devcexx/STeMCell/stemcell.kicad_pcb

## KiCad design stemcell.kicad_pcb (2025-03-15)

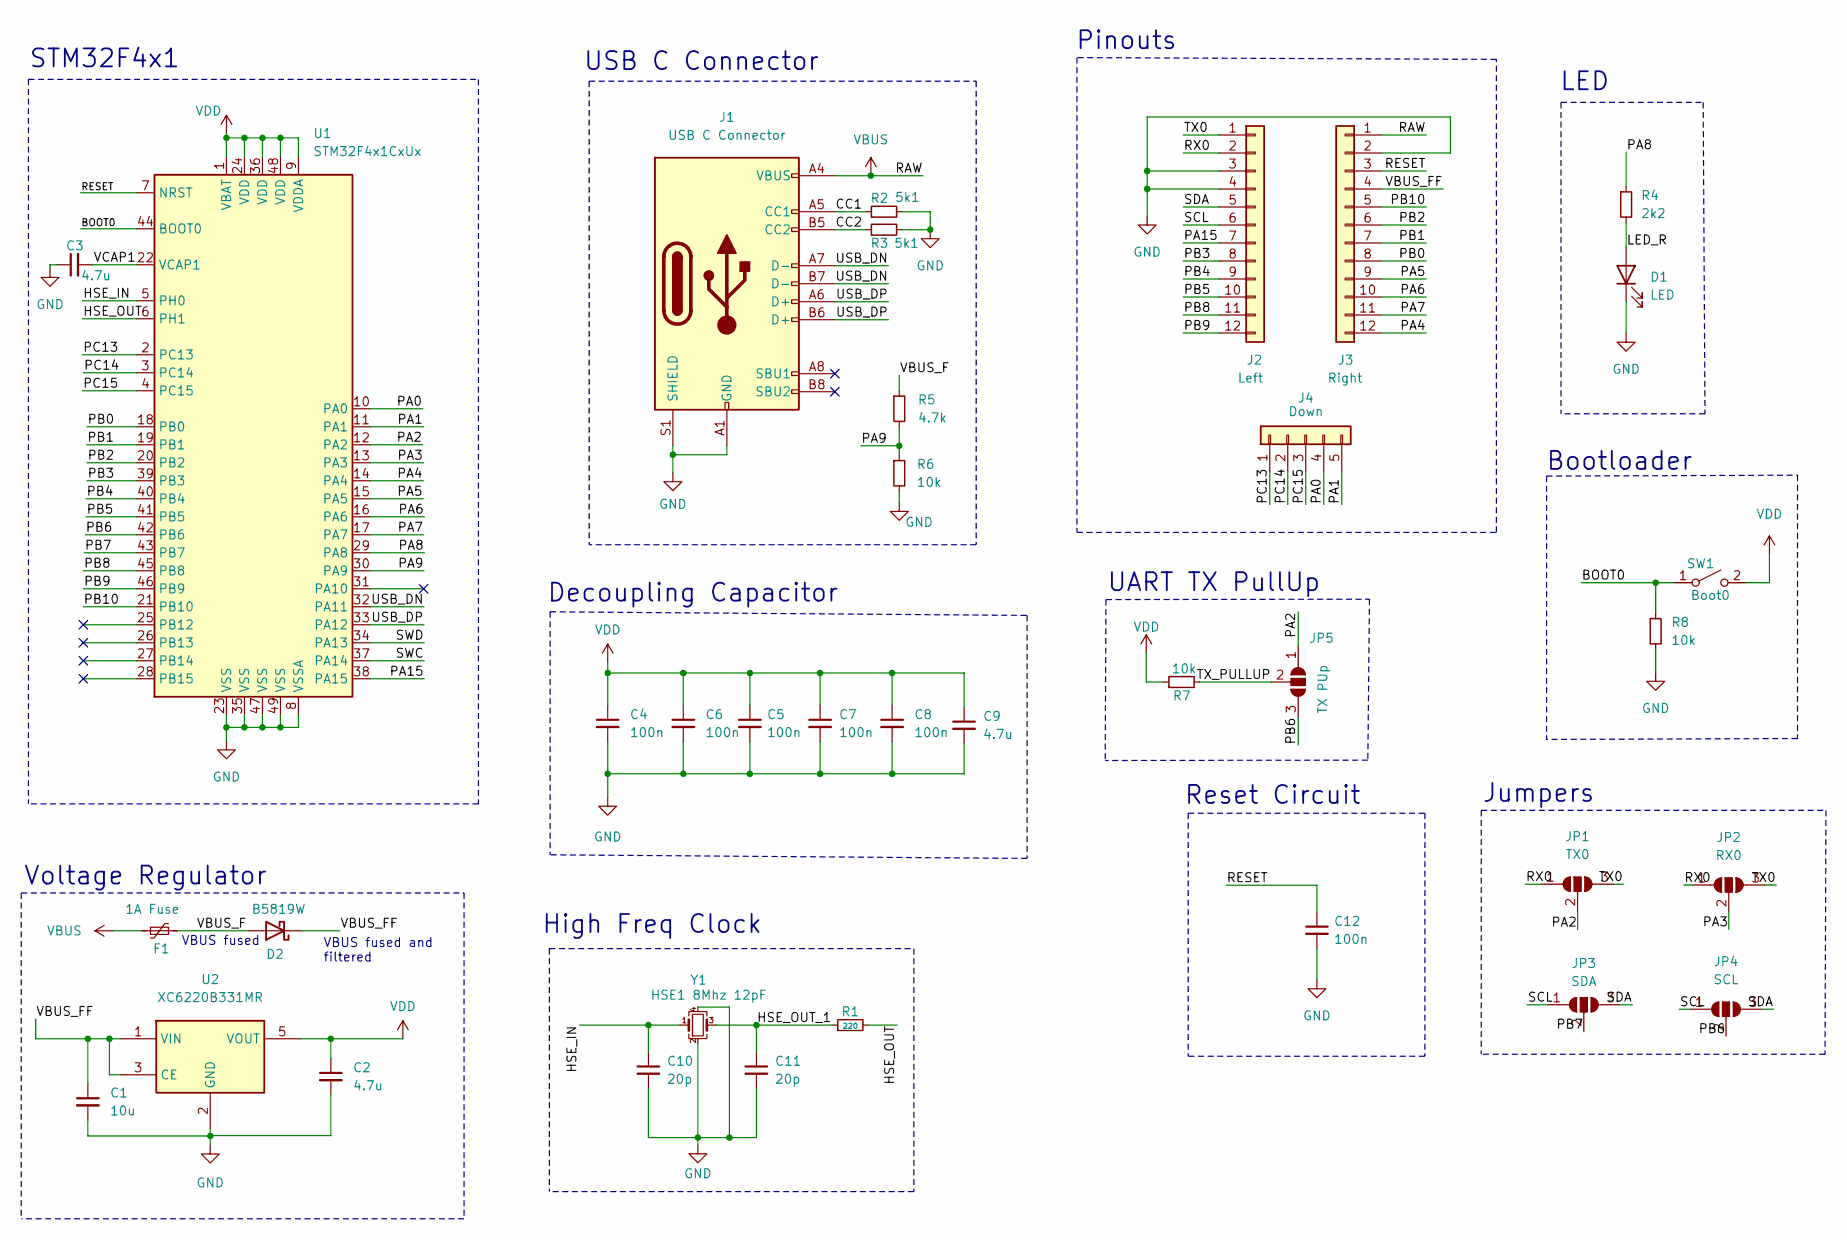
[picture p1: schematic stemcell.kicad_sch]

Parts:
C1: 10u; C_0402_1005Metric; LCSC C15525
C2, C3, C9: 4.7u; C_0402_1005Metric; LCSC C23733
C4, C5, C6, C7, C8, C12: 100n; C_0402_1005Metric; LCSC C1525
C10, C11: 20p; C_0402_1005Metric; LCSC C1554
D1: LED; LED_0402_1005Metric; LCSC C130724
D2: B5819W; D_SOD-123; LCSC C8598
F1: 1A Fuse; Fuse_0805_2012Metric; LCSC C135329
J1: USB C Connector; USB-C-SMD_MC-109-C10; LCSC C2874573
J2: Left; Pins12_castellated
J3: Right; Pins12_castellated
J4: Down; Pins5_castellated
JP1: TX0; SOLDER_JUMPER_3
JP2: RX0; SOLDER_JUMPER_3
JP3: SDA; SOLDER_JUMPER_3
JP4: SCL; SOLDER_JUMPER_3
JP5: TX PUp; SOLDER_JUMPER_3
R1: 220; R_0402_1005Metric; LCSC C25091
R2, R3: 5k1; R_0402_1005Metric; LCSC C25905
R4: 2k2; R_0402_1005Metric; LCSC C25879
R5: 4.7k; R_0402_1005Metric; LCSC C25900
R6, R7, R8: 10k; R_0402_1005Metric; LCSC C25744
SW1: Boot0; SW_SPST_CK_KXT3; LCSC C319433
U1: STM32F4x1CxUx; QFN-48-1EP_7x7mm_P0.5mm_EP5.6x5.6mm; LCSC C60420
U2: XC6220B331MR; SOT-23-5; LCSC C86534
Y1: HSE1 8Mhz 12pF; Crystal_SMD_3225-4Pin_3.2x2.5mm; LCSC C2682775

Connections:
/BOOT0: R8.1, SW1.1 (A), U1.44 (BOOT0)
/CC1: J1.A5 (CC1), R2.1
/CC2: J1.B5 (CC2), R3.1
/HSE_IN: C10.1, U1.5 (PH0), Y1.1
/HSE_OUT: R1.2, U1.6 (PH1)
/HSE_OUT_1: C11.1, R1.1, Y1.3
/LED_R: D1.2 (A), R4.2
/PA0: J4.4, U1.10 (PA0)
/PA1: J4.5, U1.11 (PA1)
/PA2: JP1.2 (C), JP5.1 (A), U1.12 (PA2)
/PA3: JP2.2 (C), U1.13 (PA3)
/PA4: J3.12, U1.14 (PA4)
/PA5: J3.9, U1.15 (PA5)
/PA6: J3.10, U1.16 (PA6)
/PA7: J3.11, U1.17 (PA7)
/PA8: R4.1, U1.29 (PA8)
/PA9: R5.2, R6.1, U1.30 (PA9)
/PA15: J2.7, U1.38 (PA15)
/PB0: J3.8, U1.18 (PB0)
/PB1: J3.7, U1.19 (PB1)
/PB2: J3.6, U1.20 (PB2)
/PB3: J2.8, U1.39 (PB3)
/PB4: J2.9, U1.40 (PB4)
/PB5: J2.10, U1.41 (PB5)
/PB6: JP4.2 (C), JP5.3 (B), U1.42 (PB6)
/PB7: JP3.2 (C), U1.43 (PB7)
/PB8: J2.11, U1.45 (PB8)
/PB9: J2.12, U1.46 (PB9)
/PB10: J3.5, U1.21 (PB10)
/PC13: J4.1, U1.2 (PC13)
/PC14: J4.2, U1.3 (PC14)
/PC15: J4.3, U1.4 (PC15)
/RESET: C12.1, J3.3, U1.7 (NRST)
/RX0: J2.2, JP1.1 (A), JP2.1 (A)
/SCL: J2.6, JP3.1 (A), JP4.1 (A)
/SDA: J2.5, JP3.3 (B), JP4.3 (B)
/SWC: U1.37 (PA14)
/SWD: U1.34 (PA13)
/TX0: J2.1, JP1.3 (B), JP2.3 (B)
/TX_PULLUP: JP5.2 (C), R7.2
/USB_DN: J1.A7 (D-), J1.B7 (D-), U1.32 (PA11)
/USB_DP: J1.A6 (D+), J1.B6 (D+), U1.33 (PA12)
/VBUS_F: D2.2 (A), F1.2, R5.1
/VBUS_FF: C1.1, D2.1 (K), J3.4, U2.1 (VIN), U2.3 (CE)
/VCAP1: C3.2, U1.22 (VCAP1)
GND: C1.2, C2.2, C3.1, C4.2, C5.2, C6.2, C7.2, C8.2, C9.2, C10.2, C11.2, C12.2, D1.1 (K), J1.A1 (GND), J1.A12 (GND), J1.B1 (GND), J1.B12 (GND), J1.S1 (SHIELD), J2.3, J2.4, J3.2, R2.2, R3.2, R6.2, R8.2, U1.8 (VSSA), U1.23 (VSS), U1.35 (VSS), U1.47 (VSS), U1.49 (VSS), U2.2 (GND), Y1.2, Y1.4
VBUS: F1.1, J1.A4 (VBUS), J1.A9 (VBUS), J1.B4 (VBUS), J1.B9 (VBUS), J3.1
VDD: C2.1, C4.1, C5.1, C6.1, C7.1, C8.1, C9.1, R7.1, SW1.2 (B), U1.1 (VBAT), U1.9 (VDDA), U1.24 (VDD), U1.36 (VDD), U1.48 (VDD), U2.5 (VOUT)

Notes on the sheet:
Jumpers
Decoupling Capacitor
STM32F4x1
Reset Circuit
VBUS fused
Voltage Regulator
LED
High Freq Clock
Bootloader
UART TX PullUp
USB C Connector
VBUS fused and filtered
Pinouts

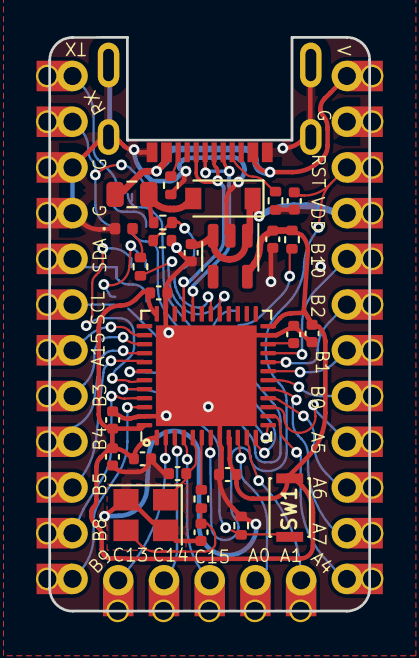
[picture p2: board stemcell.kicad_pcb from above]

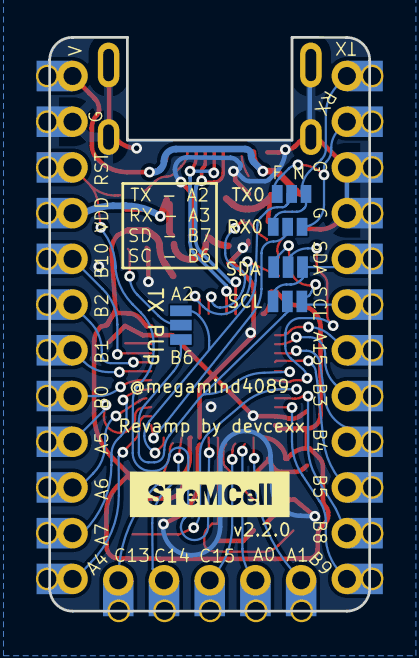
[picture p3: board stemcell.kicad_pcb from below]

Board: 2 copper layers, 17.8 x 31.9 mm, 37 parts (7 on the bottom side), 46 nets.

Other parts of the board:
kibuzzard-620B7294: G***; kibuzzard-620B7294
