devcexx/STeMCell/(commit log)

2025-03-15 Moved GND via for clearance
    [stemcell.kicad_pcb]
2025-03-15 Added watermark
    [stemcell.kicad_pcb]
2025-03-15 Bump to KiCad 9
    [stemcell.kicad_pcb]
2025-03-15 Rerouted USB section to fit replacement USB connector PN C2874573
    [stemcell.kicad_pcb, stemcell.kicad_sch]
2025-03-15 Re-routed USB signals
    [stemcell.kicad_pcb]
2025-03-15 Bumped to v2.2.0
    * Removed paste from USB-C PTH holes.
    * Added JLCPCB Rotations and position offsets for PCBA.
    * Fixed some minor issues after reviewing it for printing.
    [stemcell.kicad_pcb]
